tristanhamel06/remotedisplayesp32/hardware/boitier/a-imprimer/devant.stl

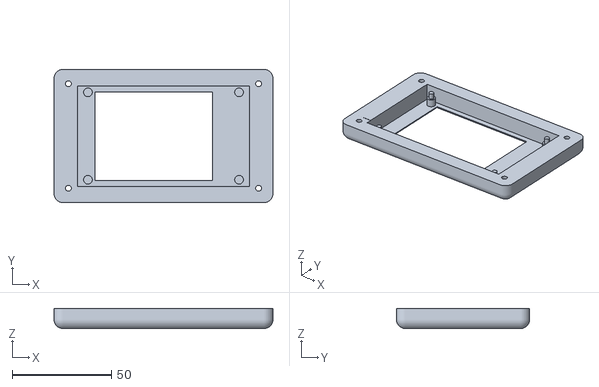
[picture p4: CAD file, 2026-11-06]
hardware/boitier/a-imprimer/devant.stl
110.2 x 67.1 x 10.1
