tristanhamel06/remotedisplayesp32/hardware/boitier/original-nachis/display-ili9341-pin-block.stl

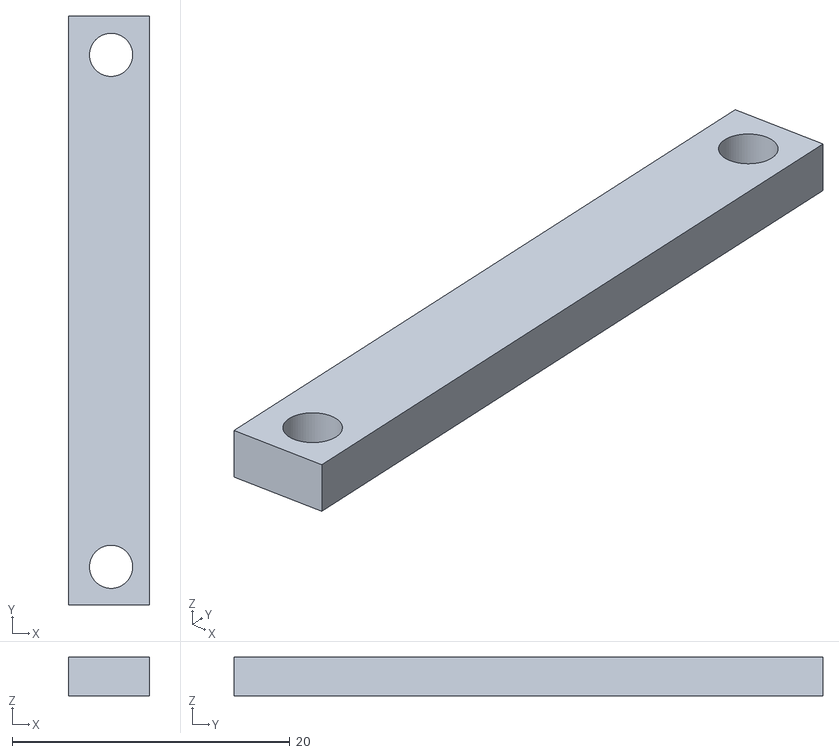
[picture p5: CAD file, 2026-10-08]
hardware/boitier/original-nachis/display-ili9341-pin-block.stl
5.80 x 42.4 x 2.80
