tristanhamel06/remotedisplayesp32/hardware/boitier/a-imprimer/arriere.stl

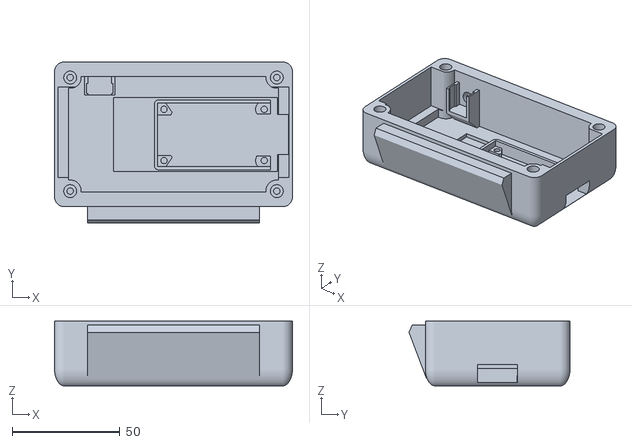
[picture p6: CAD file, 2026-10-10]
hardware/boitier/a-imprimer/arriere.stl
110.2 x 74.6 x 30.0
