tristanhamel06/remotedisplayesp32/hardware/boitier/original-nachis/display-light-bleed-blocker.stl

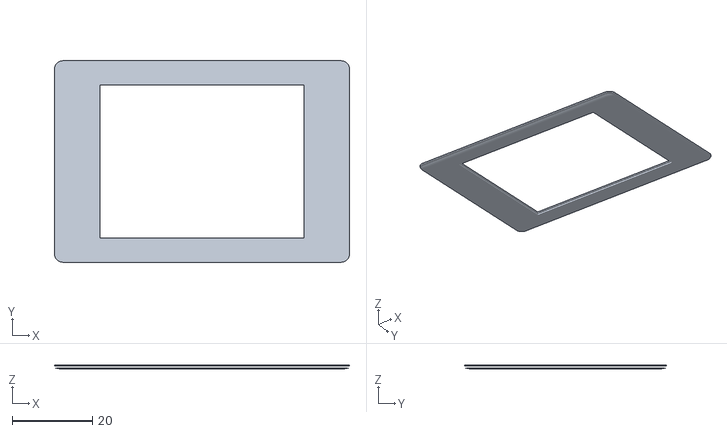
[picture p7: CAD file, 2026-10-08]
hardware/boitier/original-nachis/display-light-bleed-blocker.stl
73.7 x 50.3 x 1.01
