tristanhamel06/remotedisplayesp32/hardware/boitier/a-imprimer/bouton-porte-switch.stl

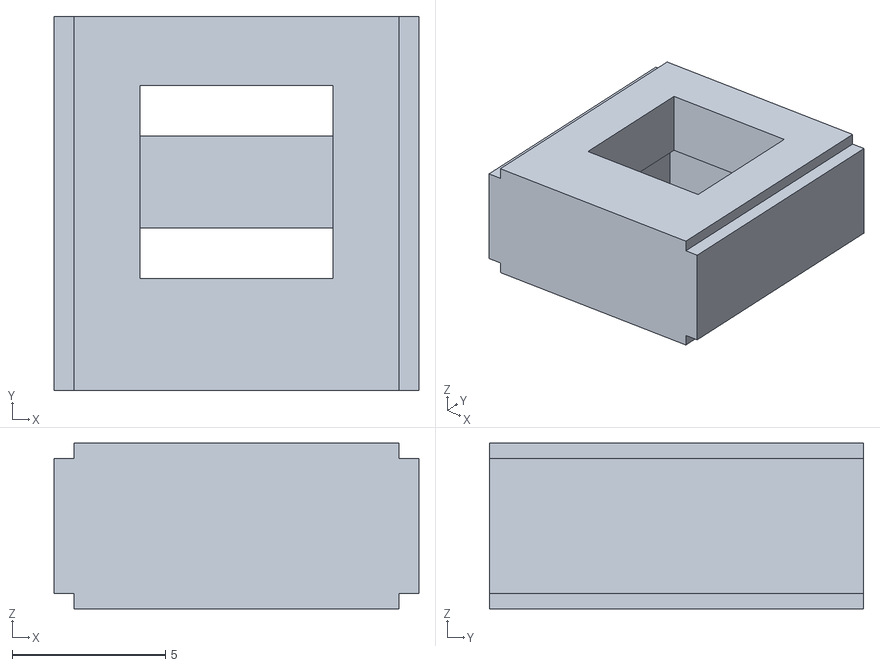
[picture p8: CAD file, 2026-10-10]
hardware/boitier/a-imprimer/bouton-porte-switch.stl
11.9 x 12.2 x 5.40
