tristanhamel06/remotedisplayesp32/hardware/boitier/original-nachis/display-front.stl

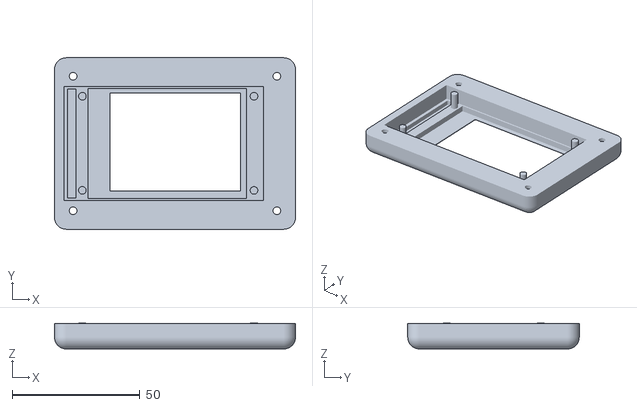
[picture p9: CAD file, 2026-10-08]
hardware/boitier/original-nachis/display-front.stl
94.2 x 67.1 x 10.1
