tristanhamel06/remotedisplayesp32/hardware/boitier/a-imprimer/bouton-piston.stl

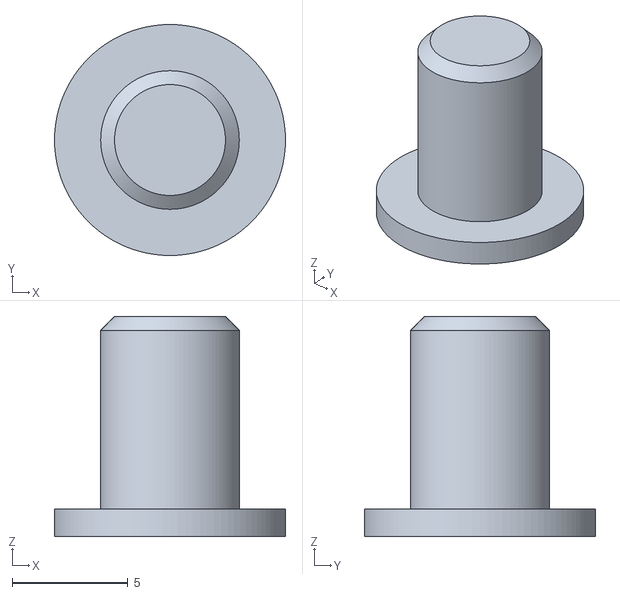
[picture p10: CAD file, 2026-10-10]
hardware/boitier/a-imprimer/bouton-piston.stl
10.0 x 10.0 x 9.53
