tristanhamel06/remotedisplayesp32/hardware/boitier/original-nachis/display-back.stl

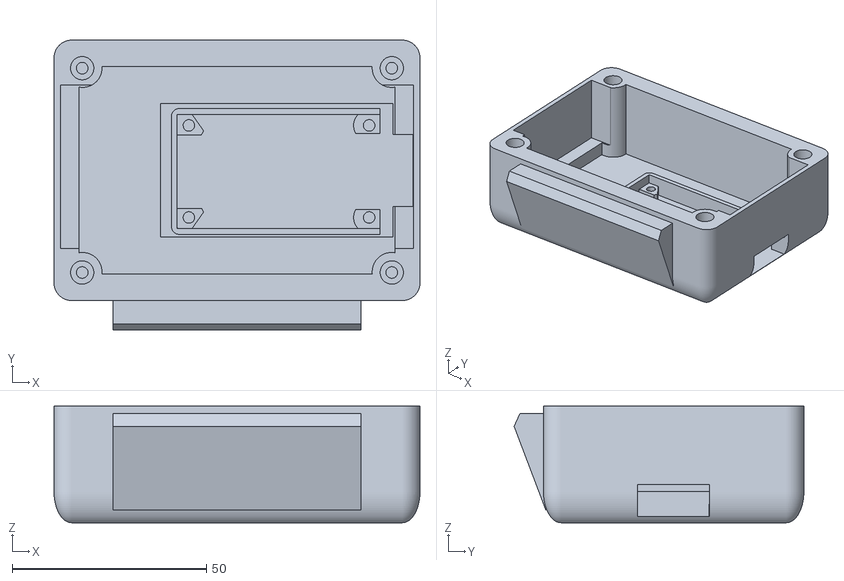
[picture p11: CAD file, 2026-10-08]
hardware/boitier/original-nachis/display-back.stl
94.2 x 74.6 x 30.0
