tristanhamel06/remotedisplayesp32/docs/schema.pdf

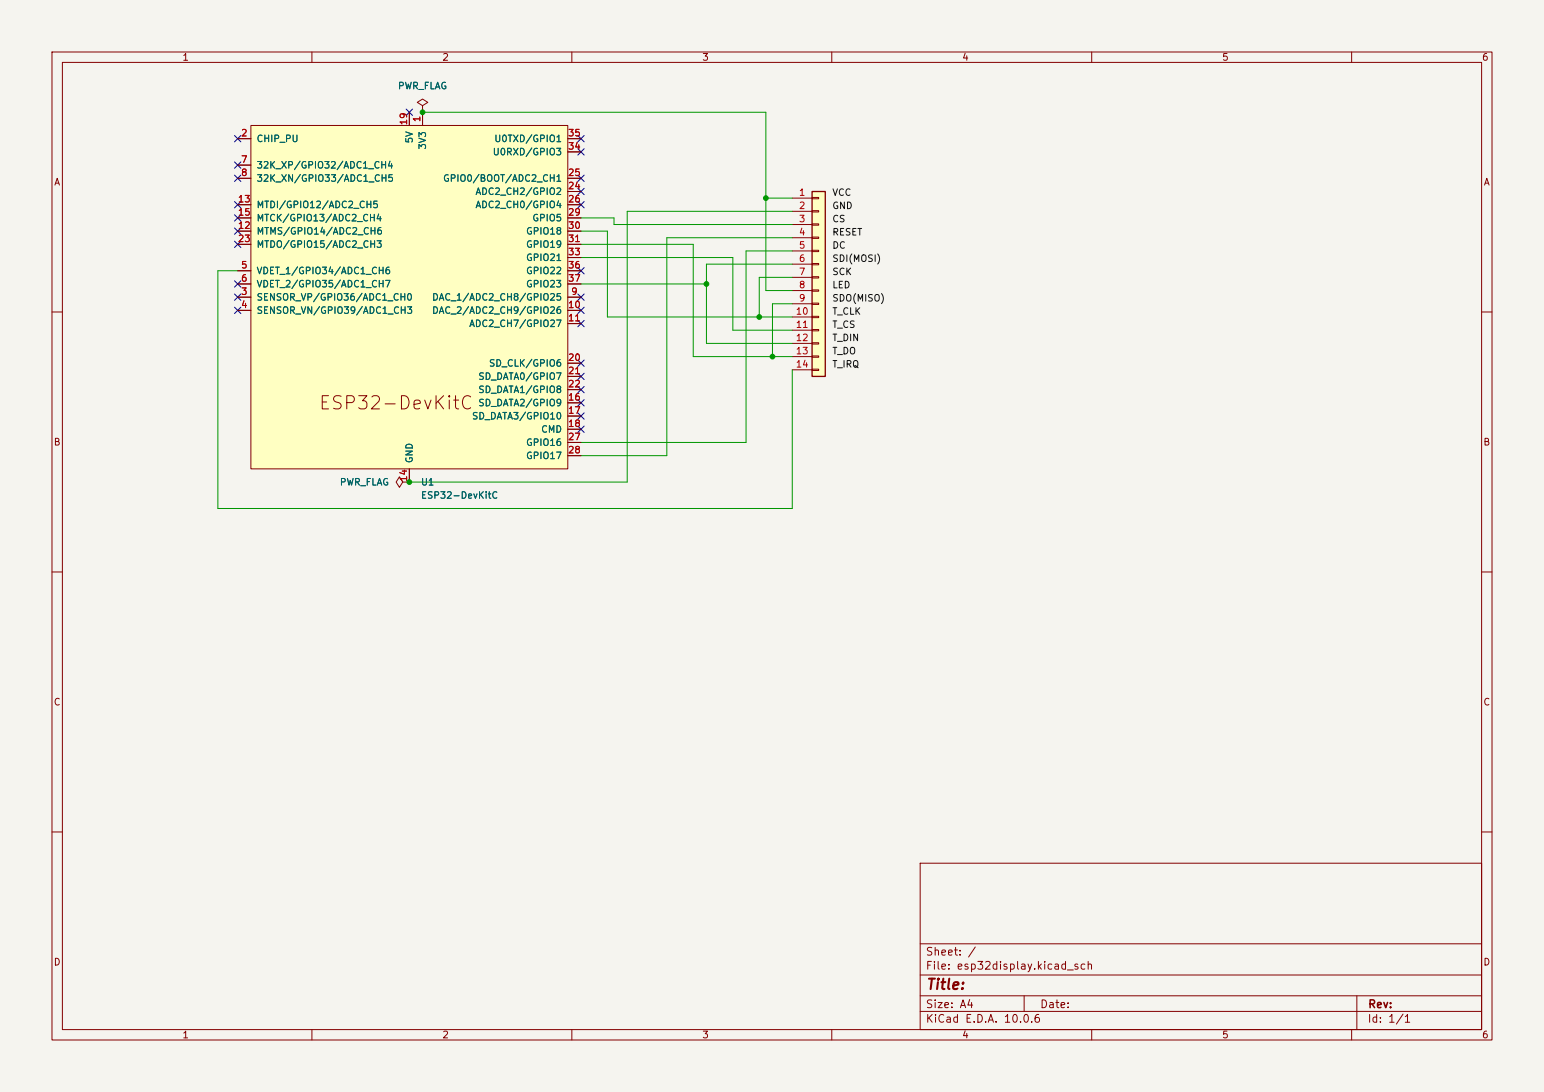
[picture p12: page 1]

11
12
13

Size: A4 | Rev:
KiCad E.D.A. 10.0.6 | Id: 1/1
