tristanhamel06/remotedisplayesp32/firmware/remotedisplay/certs.h

// Certificat racine de api.telegram.org (Go Daddy Root G2, expire en 2037).
// Permet a l'ESP32 de verifier qu'il parle vraiment a Telegram.
#pragma once

static const char TELEGRAM_ROOT_CA[] = R"EOF(
-----BEGIN CERTIFICATE-----
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
4uJEvlz36hz1
-----END CERTIFICATE-----
)EOF";
