tristanhamel06/remotedisplayesp32/firmware/remotedisplay/secrets.example.h

// Copie ce fichier en "secrets.h" et remplis-le.
// secrets.h est dans le .gitignore, donc ton token va pas sur GitHub.
#pragma once

// Le token que @BotFather t'a donne quand t'as cree ton bot
#define BOT_TOKEN "123456789:ABCdefGhIJKlmnOPQrstUVwxyz"

// Ton ID Telegram. Laisse 0 au debut : envoie un message au bot,
// il va te repondre ton ID. Mets-le ici et re-televerse.
#define OWNER_ID 0
