tristanhamel06/remotedisplayesp32/(commit log)

2026-10-08 Add KiCad schematic for the ESP32 remote display
    [esp32display.kicad_pcb, esp32display.kicad_sch]
2026-10-08 Add web-controlled firmware, README and schematic PDF
    - firmware/remotedisplay: ESP32 web server that shows text on the ILI9341 TFT
    - README with wiring table and usage
    - docs/schema.pdf exported from KiCad
    - secrets.h (WiFi credentials) ignored
2026-10-08 kikad native files for esp32->display
    [esp32display.kicad_sch]
2026-10-08 Switch to Telegram bot: send photos and text from anywhere
    - Telegram long polling with TLS (Go Daddy root CA)
    - JPEG photos decoded with TJpg_Decoder, best size picked automatically
    - Auto-sized centered text with French accents and heart emojis
    - WiFiManager captive portal for WiFi setup
    - Last message saved to LittleFS and restored at boot
    - Only OWNER_ID can send; setup mode replies with the sender's ID
2026-10-08 Add night mode and brightness control
    - Backlight moved from 3V3 to GPIO 22 (PWM)
    - Screen turns off between configurable hours (default 23h-7h, Quebec time)
    - /luminosite and /nuit Telegram commands, saved with Preferences
2026-10-08 Replace scheduled night mode with a 5-hour sleep button
    - Button on GPIO 32 toggles the backlight off for 5 hours
    - Polled in a FreeRTOS task so it reacts while loop() waits on Telegram
    - /etat command reports whether the screen is asleep
    [remotedisplay.ino]
2026-10-08 Add 3D-printed enclosure by @NachiS (Printables)
    [display-back.stl, display-front.stl, display-ili9341-pin-block.stl, display-light-bleed-blocker.stl]
2026-10-08 Add enclosure source link and CC BY-NC-SA 4.0 license notice
2026-10-10 Add TL1105 button to the enclosure (remix of @NachiS's back part)
    - display-back-bouton.stl: 6.4 mm hole in the top wall + U-channel holder
    - bouton-piston.stl and bouton-porte-switch.stl: plunger and switch carrier
    - bouton.py: generator script (manifold3d)
    - License notice lists the modifications (CC BY-NC-SA 4.0)
    [bouton-piston.stl, bouton-porte-switch.stl, display-back-bouton.stl]
2026-10-10 Button v2: switch carrier with a back bar, button moved left
    - Switch rests on a bar at the back of the carrier: no glue, force goes into the plastic
    - Fixed 0.3 mm gap to the plunger, 1.5 mm plunger travel (works for 4.1-5.3 mm switch heights)
    - Button moved 26 mm left so the switch leads stay clear of the ESP32 headers
    [bouton-porte-switch.stl, display-back-bouton.stl]
2026-10-10 Rework the enclosure for the 2.8" MSP2807 screen
    The original @NachiS model fits a 2.4" module; the 2.8" PCB (86 x 50) did not fit.
    - arriere.stl: back stretched 16 mm, button kept on the top wall
    - devant.stl: outline and screw holes kept, interior rebuilt from the MSP2807
    drawing (window over the active area, pocket, 4 locating pegs)
    - Printable files in a-imprimer/, originals in original-nachis/, generer.py builds everything
    - README and license notice updated
    [arriere.stl, bouton-piston.stl, bouton-porte-switch.stl, devant.stl, display-back-bouton.stl, display-back.stl, display-front.stl, display-ili9341-pin-block.stl]
2026-11-06 Add sleep button (GPIO32) to schematic, drop unused touch pins
    Wire TL1105 push button between GPIO32 and GND, and mark the display's
    touch pins (9-14) as no-connect since the firmware only drives the
    ILI9341 over SPI. Add the TL1105 datasheet.
    [esp32display.kicad_sch]
2026-11-06 Fix screen mounting pegs: 76.08 mm hole spacing per MSP2807 drawing
    The front part placed the PCB mounting pegs 78.08 mm apart along the
    86 mm axis, so the far pegs sat ~2 mm too far out and missed the
    display's mounting holes. Set HOLES_FROM_PINS to (4.96, 81.04) to match
    the 76.08 mm hole pitch from the lcdwiki MSP2806_Size drawing (holes
    centred on the 86 mm PCB). Regenerated devant.stl.
    [devant.stl]
